khanghuu1023/Ethernet_SPI_Circuits_ARVP/README.md

# Ethernet Circuits using the ENC424J600 IC
