khanghuu1023/Ethernet_SPI_Circuits_ARVP/sonar_ethernet.png

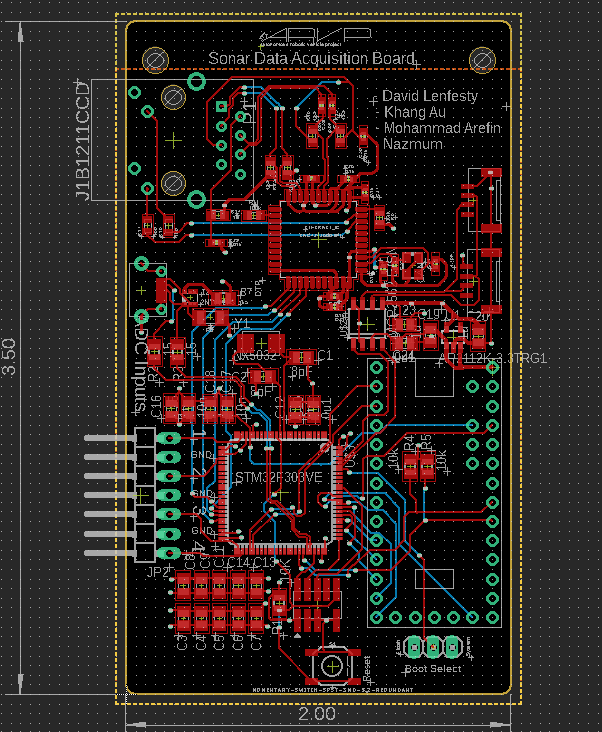
sonar_ethernet.png
