khanghuu1023/Ethernet_SPI_Circuits_ARVP/Ethernet_Implementation_BOM.xlsx

Sonar Ethernet Implementation: Bill of Materials
Shematic Reference Number | Part Description | Manufacturer Part Number | Datasheet | Price | Quantity | Total Cost | Customer Reference
U$5 | IC ETHERNET CTRLR W/SPI 44-TQFP (44-Pin QFN) | ENC424J600-I/PT | http://ww1.microchip.com/downloads/en/DeviceDoc/39935c.pdf | 5.74 | 1 | 5.74
U$6 | CRYSTAL 25.0000MHZ 4PF SMD | ABM8W-25.0000MHZ-4-B1U-T3 | https://abracon.com/Resonators/ABM8W.pdf | 0.91 | 1 | 0.91
R9, R10 | RES SMD 75 OHM 5% 1/10W 0603 | RC0603JR-0775RL | https://www.yageo.com/upload/media/product/productsearch/datasheet/rchip/PYu-RC_Group_51_RoHS_L_11.pdf | 0.14 | 2 | 0.28
D1 | LED GREEN DIFFUSED 0603 SMD | 150060VS55040 | https://www.we-online.de/web/en/index.php/download/media/07_electronic_components/download_center_1/application_notes_berichte/ano002_leds___the_future_of_hor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 | 0.24 | 1 | 0.24
D2 | LED YELLOW DIFFUSED 0603 SMD | 150060YS55040 | https://www.we-online.de/web/en/index.php/download/media/07_electronic_components/download_center_1/application_notes_berichte/ano002_leds___the_future_of_hor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 | 0.24 | 1 | 0.24
R11, R12, R15, R16 | RES 49.9 OHM 1% 1/10W 0603 | RMCF0603FT49R9 | https://www.seielect.com/catalog/sei-rmcf_rmcp.pdf | 0.1 | 4 | 0.4
P1 | CONN JACK 1PORT 100 BASE-T PCB | J1B1211CCD | http://wizwiki.net/wiki/lib/exe/fetch.php?media=products:wiz550web:wiz550webds_kr:j1b1211ccd.pdf | 3.57 | 1 | 3.57
R13 | RES SMD 10 OHM 1% 1/10W 0603 | AC0603FR-0710RL | https://www.yageo.com/upload/media/product/productsearch/datasheet/rchip/PYu-AC_51_RoHS_L_7.pdf | 0.1 | 1 | 0.1
R14 | RES 100K OHM 1% 1/10W 0603 | RT0603FRE13100KL | https://www.yageo.com/upload/media/product/productsearch/datasheet/rchip/PYu-RC_Group_51_RoHS_L_11.pdf | 0.14 | 1 | 0.14
C21, C22 , C25, C26, C27 | CAP CER 0.1UF 50V X7R 0402 | GRM155R71H104KE14D | https://search.murata.co.jp/Ceramy/image/img/A01X/G101/ENG/GRM155R71H104KE14-01.pdf | 0.14 | 5 | 0.7
C28 | CAP CER 10UF 10V X5R 0402 | CL05A106MP8NUB8 | https://media.digikey.com/pdf/Data%20Sheets/Samsung%20PDFs/CL05A106MP8NUB8_Spec.pdf | 0.5 | 1 | 0.5
R8 | RES SMD 12.4K OHM 1% 1/10W 0603 | AC0603FR-0712K4L | https://www.yageo.com/upload/media/product/productsearch/datasheet/rchip/PYu-AC_51_RoHS_L_7.pdf | 0.14 | 1 | 0.14
C29, C32 | CAP CER 10000PF 50V X7R 0402 | GCM155R71H103KA55D | https://search.murata.co.jp/Ceramy/image/img/A01X/G101/ENG/GCM155R71H103KA55-01.pdf | 0.14 | 2 | 0.28
C33, C34 | CAP CER 4.7PF 50V C0G/NP0 0402 | GRM1555C1H4R7CA01D | https://www.murata.com/-/media/webrenewal/support/library/catalog/products/capacitor/ceramiccapacitor/c02e.ashx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 | 0.14 | 2 | 0.28
C30 , C31 | CAP CER 6800PF 50V X7R 0402 | GRM155R71H682JA88D | https://search.murata.co.jp/Ceramy/image/img/A01X/G101/ENG/GRM155R71H682JA88-01.pdf | 0.14 | 2 | 0.28
 |  |  |  |  |  | 0
 |  |  |  |  |  | 0
 |  |  |  |  |  | 0
 |  |  |  |  |  | 0
 |  |  |  |  |  | 0
 |  |  |  |  |  | 0
 |  |  |  |  |  | 0
 |  |  |  |  |  | 0
 |  |  |  |  |  | 0
 |  |  |  |  |  | 0
 |  |  |  |  |  | 0
 |  |  |  |  |  | 0
 |  |  |  |  |  | 0
 |  |  |  |  |  | 0
 |  |  |  |  |  | 0
 |  |  |  |  | Total | 13.8
