khanghuu1023/Ethernet_SPI_Circuits_ARVP/integrated_adc.brd

## EAGLE design integrated_adc.brd (2021-09-14)

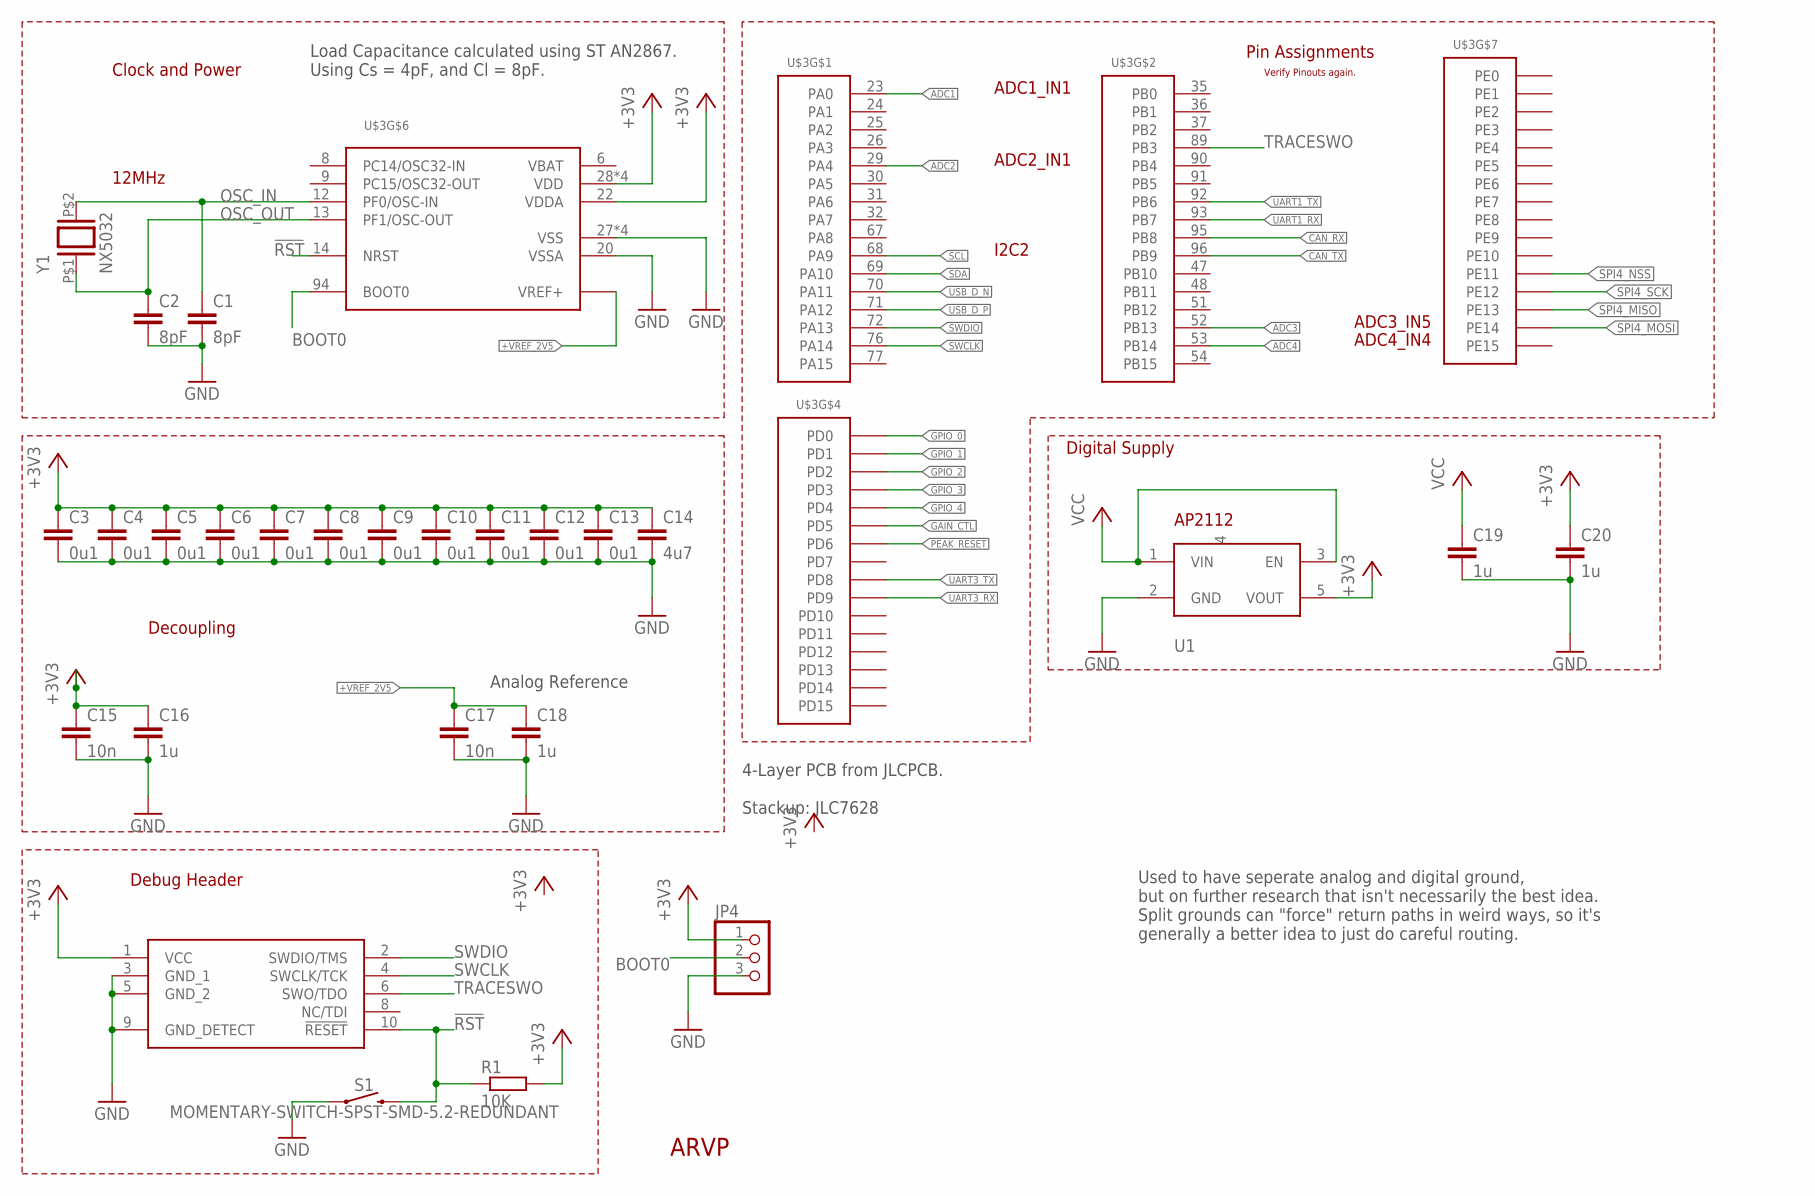
[picture p2: schematic integrated_adc.sch, sheet 1, <h1>MCU + Periphery</h1> Ethernet Implementation <p> Power,…]

Parts:
ARVP1: ARVP_LOGO; ARVP
C1, C2: 8pF; C0805
C3, C4, C5, C6, C7, C8, C9, C10, C11, C12, C13: 0u1; C0805
C14: 4u7; C0805
C15, C17: 10n; C0805
C16, C18, C19, C20: 1u; C0805
JP1: CORTEX-M-DBG; FTSH-105-01-F-DV-007
JP4: PINHD-1X3; 1X03
R1: 10K; R0805
S1: MOMENTARY-SWITCH-SPST-SMD-5.2-REDUNDANT; TACTILE_SWITCH_SMD_5.2MM
U1: AP2112K-3.3TRG1; SOT25
U$3: STM32F303VE; LQFP100
Y1: NX5032

Connections:
!RST: JP1.10 (!RESET), R1.1, S1.3 (2), S1.4 (2), U$3.14 (NRST)
+3V3: C3.1, C4.1, C5.1, C6.1, C7.1, C8.1, C9.1, C10.1, C11.1, C12.1, C13.1, C14.1, C15.1, C16.1, C20.1, JP1.1 (VCC), JP4.1, R1.2, U1.5 (VOUT), U$3.22 (VDDA), U$3.28 (VDD), U$3.50 (VDD), U$3.75 (VDD), U$3.100 (VDD); also elsewhere on the board
+VREF_2V5: C17.1, C18.1, U$3.21 (VREF+); also elsewhere on the board
ADC1: U$3.23 (PA0); also elsewhere on the board
ADC2: U$3.29 (PA4); also elsewhere on the board
ADC3: U$3.52 (PB13); also elsewhere on the board
ADC4: U$3.53 (PB14); also elsewhere on the board
BOOT0: JP4.2, U$3.94 (BOOT0)
CAN_RX: U$3.95 (PB8); also elsewhere on the board
CAN_TX: U$3.96 (PB9); also elsewhere on the board
GAIN_CTL: U$3.86 (PD5); also elsewhere on the board
GND: C1.2, C2.2, C3.2, C4.2, C5.2, C6.2, C7.2, C8.2, C9.2, C10.2, C11.2, C12.2, C13.2, C14.2, C15.2, C16.2, C17.2, C18.2, C19.2, C20.2, JP1.3 (GND_1), JP1.5 (GND_2), JP1.9 (GND_DETECT), JP4.3, S1.1, S1.2 (1), U1.2 (GND), U$3.20 (VSSA), U$3.27 (VSS), U$3.49 (VSS), U$3.74 (VSS), U$3.99 (VSS); also elsewhere on the board
GPIO_0: U$3.81 (PD0); also elsewhere on the board
GPIO_1: U$3.82 (PD1); also elsewhere on the board
GPIO_2: U$3.83 (PD2); also elsewhere on the board
GPIO_3: U$3.84 (PD3); also elsewhere on the board
GPIO_4: U$3.85 (PD4); also elsewhere on the board
OSC_IN: C1.1, U$3.12 (PF0/OSC-IN), Y1.P$2 (2)
OSC_OUT: C2.1, U$3.13 (PF1/OSC-OUT), Y1.P$1 (1)
PEAK_RESET: U$3.87 (PD6); also elsewhere on the board
SCL: U$3.68 (PA9); also elsewhere on the board
SDA: U$3.69 (PA10); also elsewhere on the board
SPI4_MISO: U$3.44 (PE13); also elsewhere on the board
SPI4_MOSI: U$3.45 (PE14); also elsewhere on the board
SPI4_NSS: U$3.42 (PE11); also elsewhere on the board
SPI4_SCK: U$3.43 (PE12); also elsewhere on the board
SWCLK: JP1.4 (SWCLK/TCK), U$3.76 (PA14)
SWDIO: JP1.2 (SWDIO/TMS), U$3.72 (PA13)
TRACESWO: JP1.6 (SWO/TDO), U$3.89 (PB3)
UART1_RX: U$3.93 (PB7)
UART1_TX: U$3.92 (PB6)
UART3_RX: U$3.56 (PD9); also elsewhere on the board
UART3_TX: U$3.55 (PD8); also elsewhere on the board
USB_D_N: U$3.70 (PA11); also elsewhere on the board
USB_D_P: U$3.71 (PA12); also elsewhere on the board
VCC: C19.1, U1.1 (VIN), U1.3 (EN); also elsewhere on the board

Notes on the sheet:
12MHz
ADC1_IN1
ADC2_IN1
ADC3_IN5
ADC4_IN4
Pin Assignments
Decoupling
Clock and Power
Debug Header
Verify Pinouts again.
I2C2
Analog Reference
Digital Supply
Used to have seperate analog and digital ground, but on further research that isn't necessarily the best idea. Split grounds can "force" return paths in weird ways, so it's generally a better idea to just do careful routing.
4-Layer PCB from JLCPCB. Stackup: JLC7628
Load Capacitance calculated using ST AN2867. Using Cs = 4pF, and Cl = 8pF.

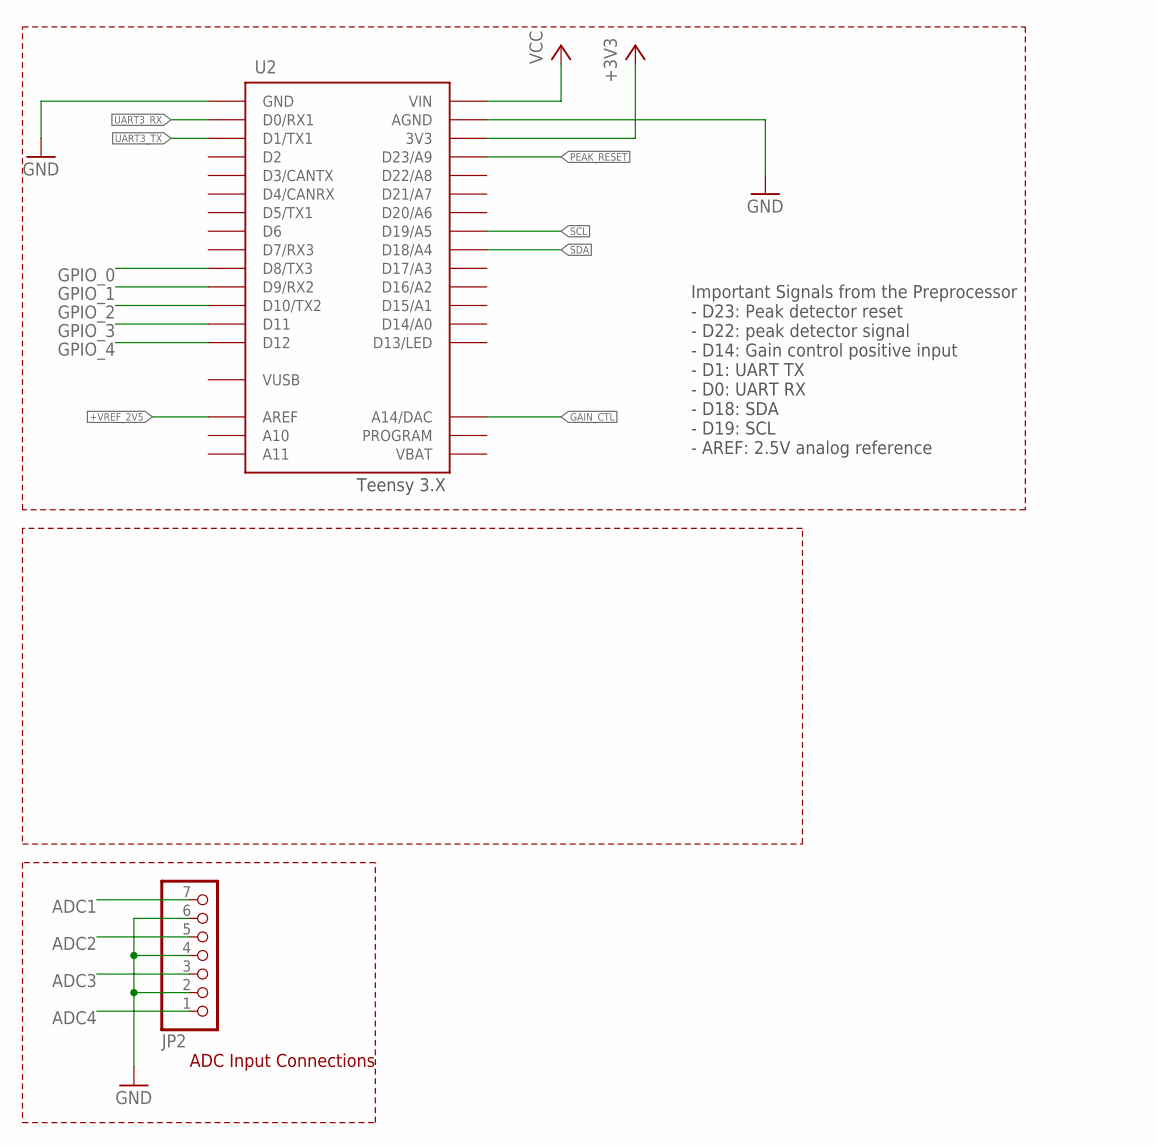
[picture p3: schematic integrated_adc.sch, sheet 2, <h1>Analog Measurement + Inputs</h1> <p> Has the external A…]

Parts:
JP2: PINHD-1X7/90; 1X07/90
U2: TEENSY_3.X_PINOUT

Connections:
+3V3: U2.3V3, U2.3V3_2 (3V3); also elsewhere on the board
+VREF_2V5: U2.AREF; also elsewhere on the board
ADC1: JP2.7; also elsewhere on the board
ADC2: JP2.5; also elsewhere on the board
ADC3: JP2.3; also elsewhere on the board
ADC4: JP2.1; also elsewhere on the board
GAIN_CTL: U2.A14 (A14/DAC); also elsewhere on the board
GND: JP2.2, JP2.4, JP2.6, U2.AGND, U2.GND_1 (GND), U2.GND_2 (GND); also elsewhere on the board
GPIO_0: U2.D8 (D8/TX3); also elsewhere on the board
GPIO_1: U2.D9 (D9/RX2); also elsewhere on the board
GPIO_2: U2.D10 (D10/TX2); also elsewhere on the board
GPIO_3: U2.D11; also elsewhere on the board
GPIO_4: U2.D12; also elsewhere on the board
PEAK_RESET: U2.D23 (D23/A9); also elsewhere on the board
SCL: U2.D19 (D19/A5); also elsewhere on the board
SDA: U2.D18 (D18/A4); also elsewhere on the board
UART3_RX: U2.D0 (D0/RX1); also elsewhere on the board
UART3_TX: U2.D1 (D1/TX1); also elsewhere on the board
VCC: U2.VIN; also elsewhere on the board
VUSB: U2.VUSB

Notes on the sheet:
ADC Input Connections
Important Signals from the Preprocessor - D23: Peak detector reset - D22: peak detector signal - D14: Gain control positive input - D1: UART TX - D0: UART RX - D18: SDA - D19: SCL - AREF: 2.5V analog reference

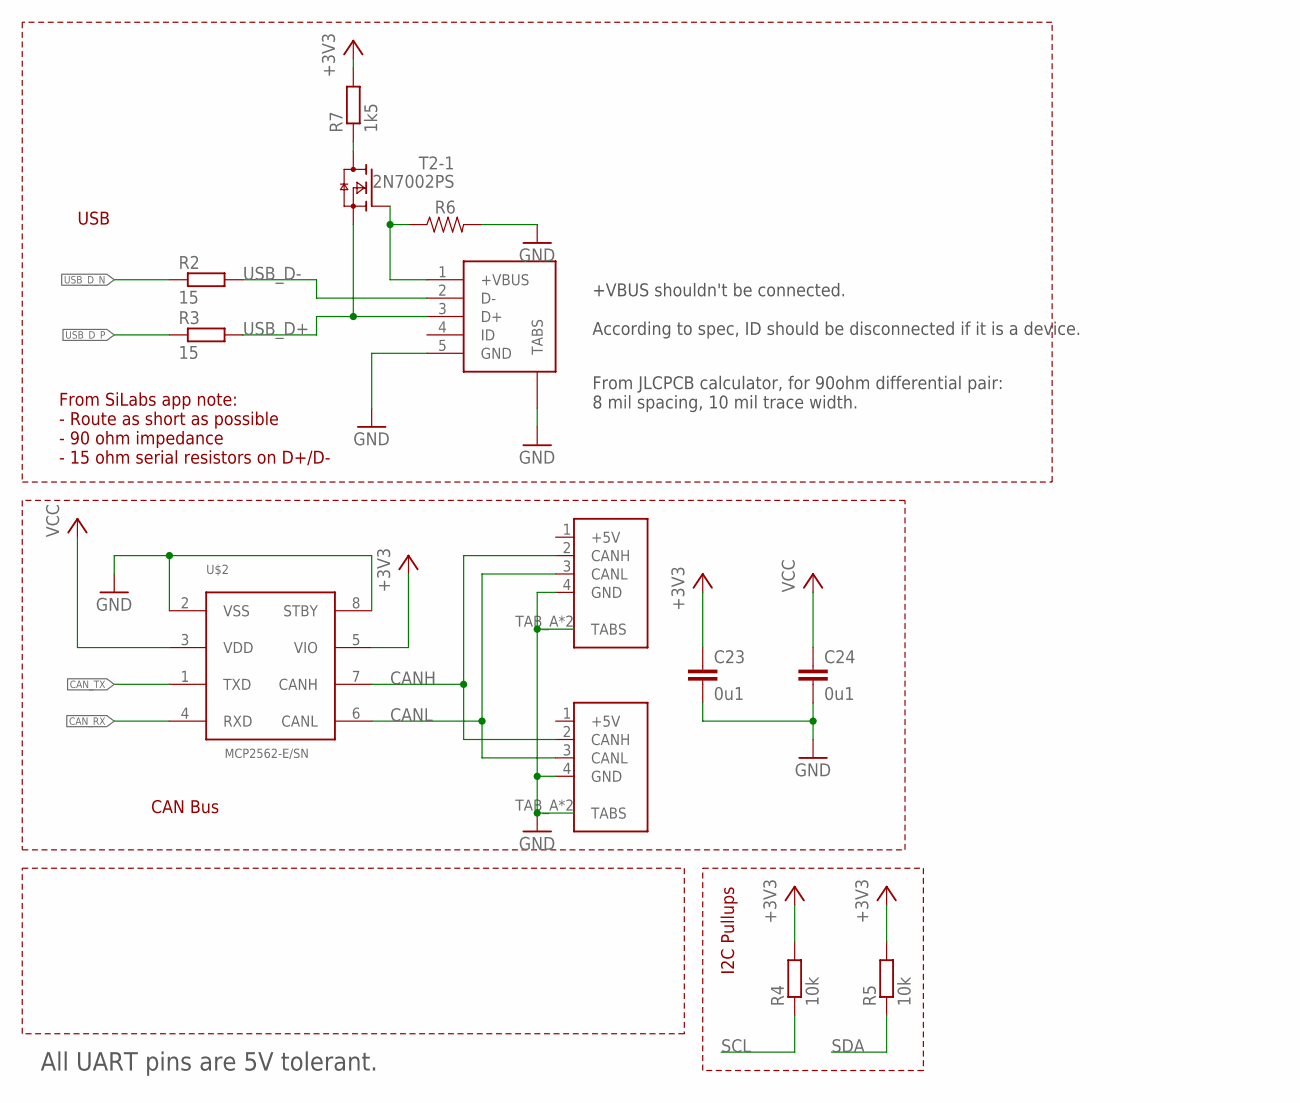
[picture p4: schematic integrated_adc.sch, sheet 3, <h1>Communications</h1>]

Parts:
C23, C24: 0u1; C0805
CON1, CON2: UAVCAN_MICRO; SM04B-GHS-TB
R2, R3: 15; R0805
R4, R5: 10k; R0805
R6: 1206
R7: 1k5; R0805
T2: 2N7002PS; SOT363
U$2: MCP2562-E/SN; SOIC8
U$4: AMPHENOL_MICROB-USB; AMPHENOL_MICROB_SMD

Connections:
+3V3: C23.1, R4.2, R5.2, R7.2, U$2.5 (VIO); also elsewhere on the board
CANH: CON1.2 (CANH), CON2.2 (CANH), U$2.7 (CANH)
CANL: CON1.3 (CANL), CON2.3 (CANL), U$2.6 (CANL)
CAN_RX: U$2.4 (RXD); also elsewhere on the board
CAN_TX: U$2.1 (TXD); also elsewhere on the board
GND: C23.2, C24.2, CON1.4 (GND), CON1.TAB_A (TABS), CON1.TAB_B (TABS), CON2.4 (GND), CON2.TAB_A (TABS), CON2.TAB_B (TABS), R6.2, U$2.2 (VSS), U$2.8 (STBY), U$4.5 (GND), U$4.TAB1 (TABS), U$4.TAB2 (TABS), U$4.TAB3 (TABS), U$4.TAB4 (TABS); also elsewhere on the board
unnamed: R6.1, T2.2 (G), U$4.1 (+VBUS)
unnamed: R7.1, T2.6 (D)
SCL: R4.1; also elsewhere on the board
SDA: R5.1; also elsewhere on the board
USB_D+: R3.2, T2.1 (S), U$4.3 (D+)
USB_D-: R2.2, U$4.2 (D-)
USB_D_N: R2.1; also elsewhere on the board
USB_D_P: R3.1; also elsewhere on the board
VCC: C24.1, U$2.3 (VDD); also elsewhere on the board

Notes on the sheet:
From SiLabs app note: - Route as short as possible - 90 ohm impedance - 15 ohm serial resistors on D+/D-
+VBUS shouldn't be connected. According to spec, ID should be disconnected if it is a device.
CAN Bus
USB
All UART pins are 5V tolerant.
From JLCPCB calculator, for 90ohm differential pair: 8 mil spacing, 10 mil trace width.
I2C Pullups

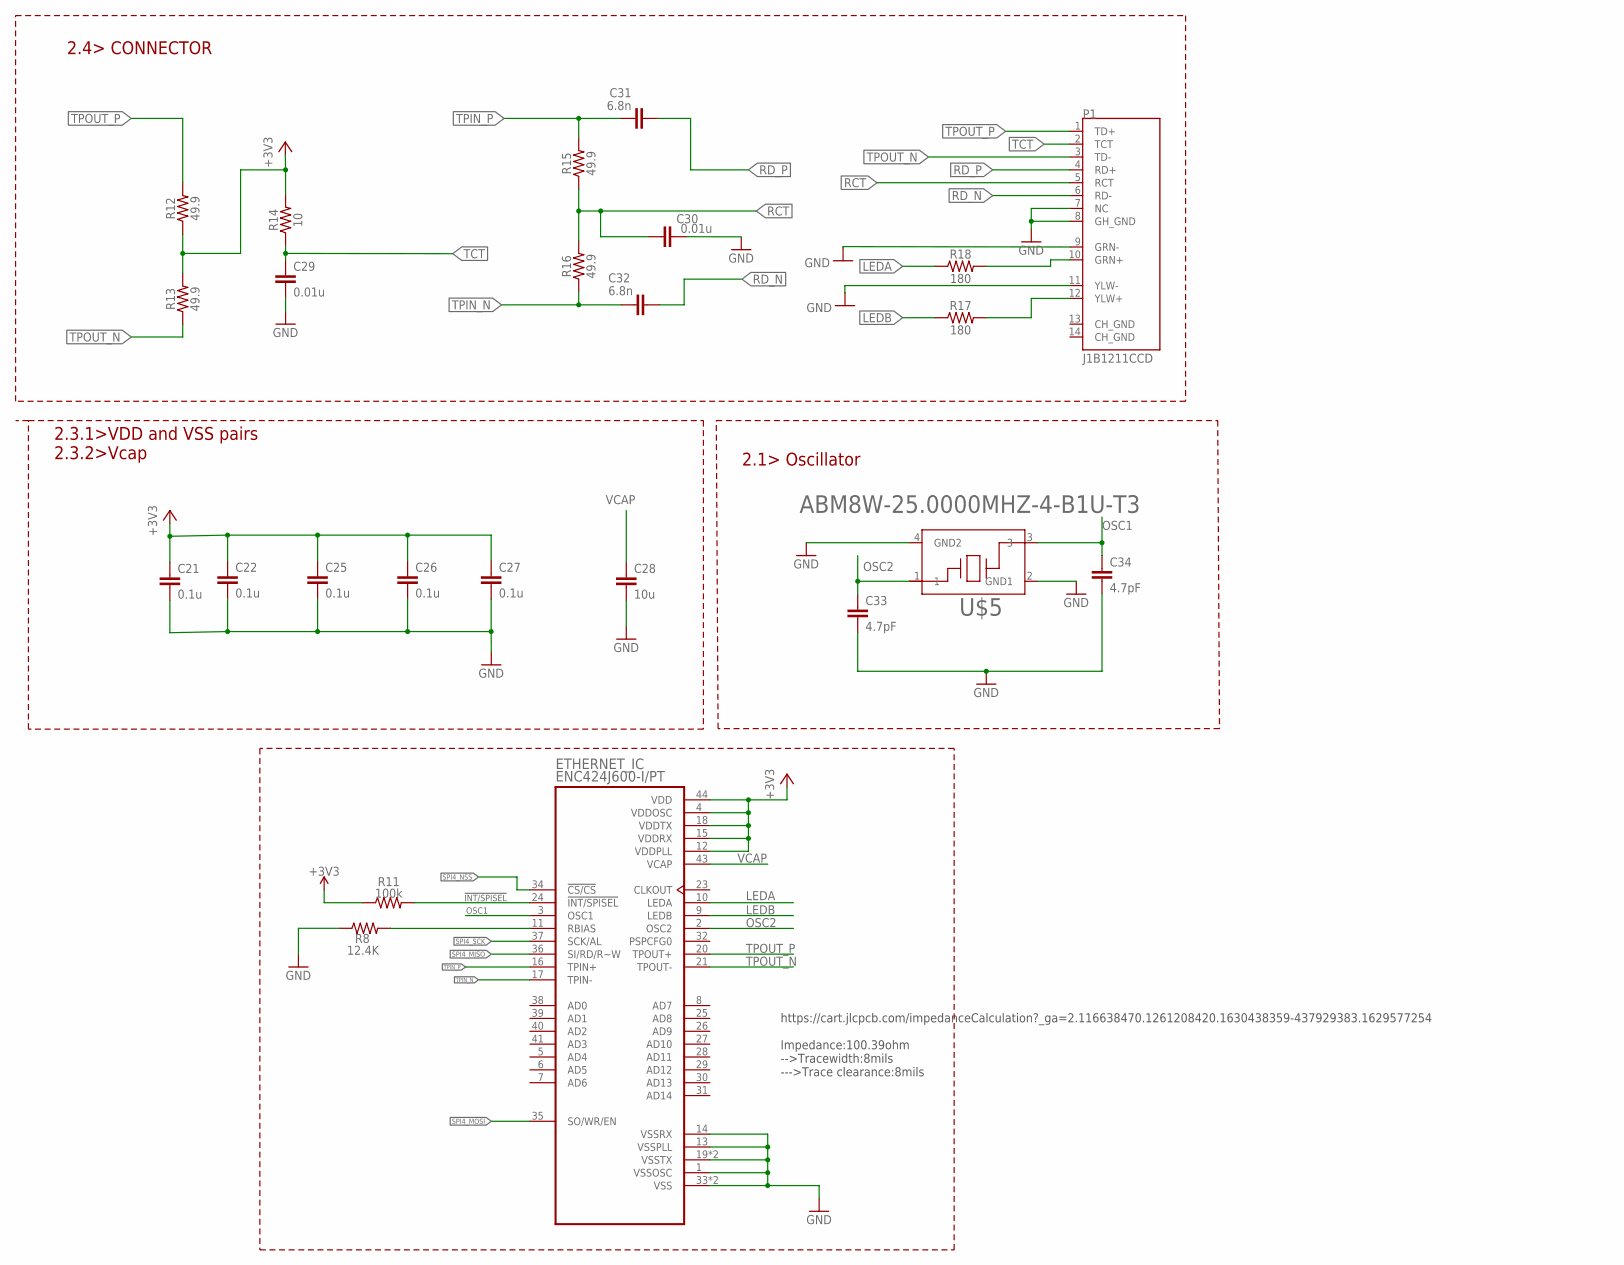
[picture p5: schematic integrated_adc.sch, sheet 4, Ethernet Implementation]

Parts:
C21, C22, C25, C26, C27: 0.1u; C0402
C28: 10u; C0402
C29, C30: 0.01u; C0402
C31, C32: 6.8n; C0402
C33, C34: 4.7pF; C0402
ETHERNET_IC: ENC424J600-I/PT; QFP80P1200X1200X120-44N
P1: J1B1211CCD
R8: 12.4K; 0603
R11: 100k; 0603
R12, R13, R15, R16: 49.9; 0603
R14: 10; 0603
R17, R18: 180; RESC1608X55N
U$5: ABM8W-25.0000MHZ-4-B1U-T3; XTAL_ABM8W-25.0000MHZ-4-B1U-T3

Connections:
!INT/SPISEL!: ETHERNET_IC.24 (!INT/SPISEL), R11.2
+3.3V: R11.1
+3V3: C21.1, C22.1, C25.1, C26.1, C27.1, ETHERNET_IC.4 (VDDOSC), ETHERNET_IC.12 (VDDPLL), ETHERNET_IC.15 (VDDRX), ETHERNET_IC.18 (VDDTX), ETHERNET_IC.44 (VDD), R12.1, R13.2, R14.2; also elsewhere on the board
GND: C21.2, C22.2, C25.2, C26.2, C27.2, C28.2, C29.2, C30.2, C33.2, C34.2, ETHERNET_IC.1 (VSSOSC), ETHERNET_IC.13 (VSSPLL), ETHERNET_IC.14 (VSSRX), ETHERNET_IC.19 (VSSTX), ETHERNET_IC.22 (VSSTX), ETHERNET_IC.33 (VSS), ETHERNET_IC.42 (VSS), P1.7 (NC), P1.8 (GH_GND), P1.9 (GRN-), P1.11 (YLW-), R8.1, U$5.2 (GND1), U$5.4 (GND2); also elsewhere on the board
LEDA: ETHERNET_IC.10 (LEDA), R18.1
LEDB: ETHERNET_IC.9 (LEDB), R17.1
unnamed: P1.10 (GRN+), R18.2
unnamed: P1.12 (YLW+), R17.2
OSC1: C34.1, ETHERNET_IC.3 (OSC1), U$5.3
OSC2: C33.1, ETHERNET_IC.2 (OSC2), U$5.1
RBIAS: ETHERNET_IC.11 (RBIAS), R8.2
RCT: C30.1, P1.5 (RCT), R15.1, R16.2
RD_N: C32.1, P1.6 (RD-)
RD_P: C31.2, P1.4 (RD+)
SPI4_MISO: ETHERNET_IC.36 (SI/RD/R~W); also elsewhere on the board
SPI4_MOSI: ETHERNET_IC.35 (SO/WR/EN); also elsewhere on the board
SPI4_NSS: ETHERNET_IC.34 (!CS/CS); also elsewhere on the board
SPI4_SCK: ETHERNET_IC.37 (SCK/AL); also elsewhere on the board
TCT: C29.1, P1.2 (TCT), R14.1
TPIN_N: C32.2, ETHERNET_IC.17 (TPIN-), R16.1
TPIN_P: C31.1, ETHERNET_IC.16 (TPIN+), R15.2
TPOUT_N: ETHERNET_IC.21 (TPOUT-), P1.3 (TD-), R13.1
TPOUT_P: ETHERNET_IC.20 (TPOUT+), P1.1 (TD+), R12.2
VCAP: C28.1, ETHERNET_IC.43 (VCAP)

Notes on the sheet:
2.1> Oscillator
2.3.1>VDD and VSS pairs 2.3.2>Vcap
2.4> CONNECTOR
https://cart.jlcpcb.com/impedanceCalculation?_ga=2.116638470.1261208420.1630438359-437929383.1629577254 Impedance:100.39ohm -->Tracewidth:8mils --->Trace clearance:8mils

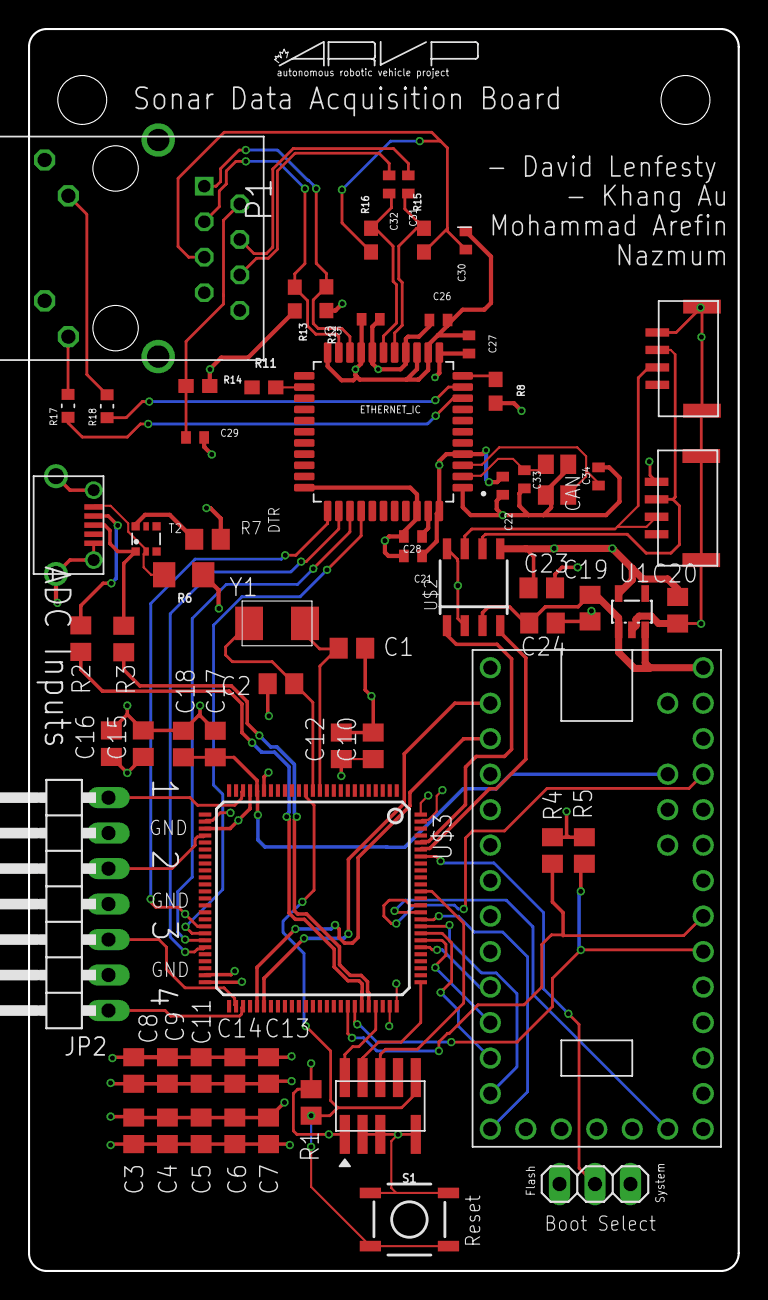
[picture p6: board integrated_adc.brd from above]

Board: 4 copper layers, 50.8 x 88.9 mm, 67 parts (0 on the bottom side), 57 nets.
