khanghuu1023/Ethernet_SPI_Circuits_ARVP/(commit log)

2021-09-14 Completed Ethernet Circuits
    [BOM.csv, Ethernet_Implementation_BOM.xlsx, integrated_adc.brd, integrated_adc.sch]
2021-09-14 Fix Names and Titles
    [integrated_adc.brd]
2021-09-14 Add an image of the whole board
2021-09-19 update BOM File
    [BOM.csv]
